macblair221/eeg-signal-acquisition/README.md

# Low-Cost Electrophysiology Acquisition System

A personal engineering project building a reproducible, low-cost bio-signal acquisition pipeline from bare analog front-end hardware to digital neural data analysis.

## Project Goal

Develop a low-cost, full-stack system for collecting and analyzing electrophysiological biosignals (ECG/EEG) using off-the-shelf components. This project bridges analog signal conditioning, microcontroller-based digital telemetry, and Python-based signal processing to successfully extract and analyze microvolt-level biological signals. 

This project is for learning, prototyping, and non-medical experimentation only.

## Current Progress & Milestones Achieved

### 1. Analog Front-End Hardware (Completed)
- Designed and simulated a full analog signal chain in LTspice using an AD620ANZ instrumentation amplifier and TL084 op-amp gain stages.
- Successfully built the physical circuit on a breadboard, implementing an RC high-pass filter for low-frequency drift reduction and an RC low-pass filter ($f_c \approx 40.8\text{ Hz}$) to attenuate 60Hz interference.
- Engineered a 2.4V DC bias to safely couple the alternating biological current into the Arduino's 0-5V digital domain.

### 2. Digital Telemetry & Data Acquisition (Completed)
- Established a real-time serial communication bridge using an Arduino Nano Every.
- Wrote a Python collection script utilizing `pyserial` to capture the 10-bit ADC byte stream at a 200Hz sampling rate and log the raw telemetry to a local CSV.

### 3. Signal Processing & Algorithm Validation (IP)
- Ingested the raw hardware array into `mne-python` 
- Applied a 1Hz to 40Hz digital bandpass filter to eliminate residual DC baseline wander and high-frequency breadboard noise.
- Engineered and debugged an automated peak-detection algorithm using `scipy.signal.find_peaks`, utilizing minimum-voltage thresholds to prevent false-positive wave detection and extract a resting heart rate.

## Results & Signal Processing

The system was validated using a Lead I ECG placement (gold-plated cup electrodes and Ten20 conductive paste).

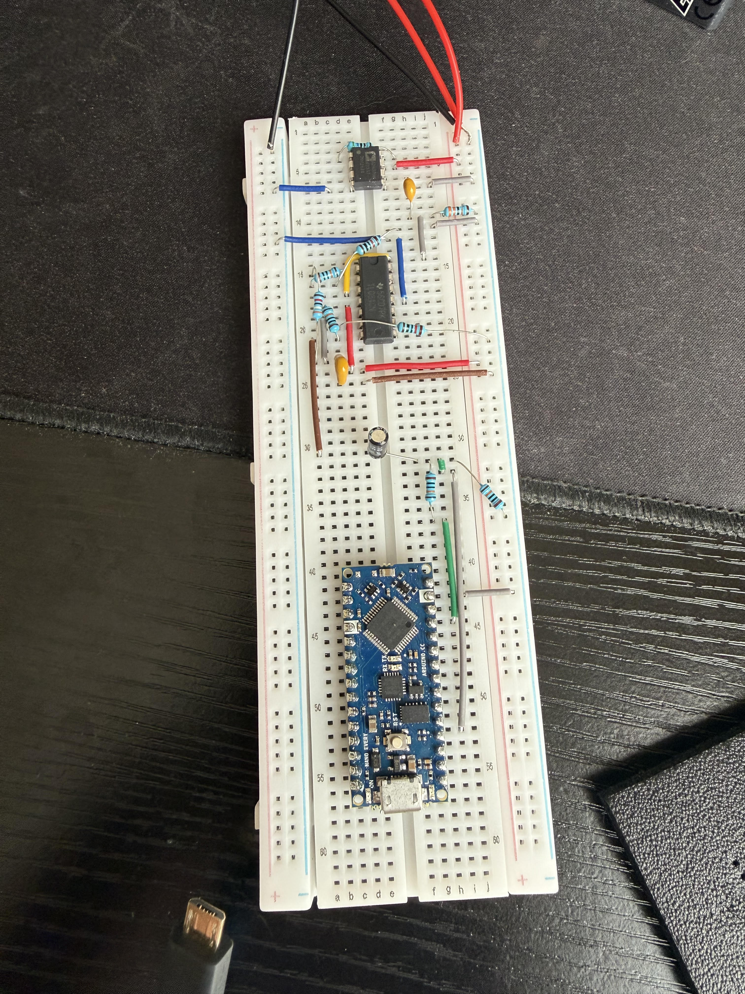
[picture p1: images/real_circuit_build.jpg]
Full Circuit


*The physical analog amplification and filtering chain bridged to the Arduino 10-bit ADC.*

## Simulation Gallery

LTspice schematic design for analog front-end using universal OpAmp.

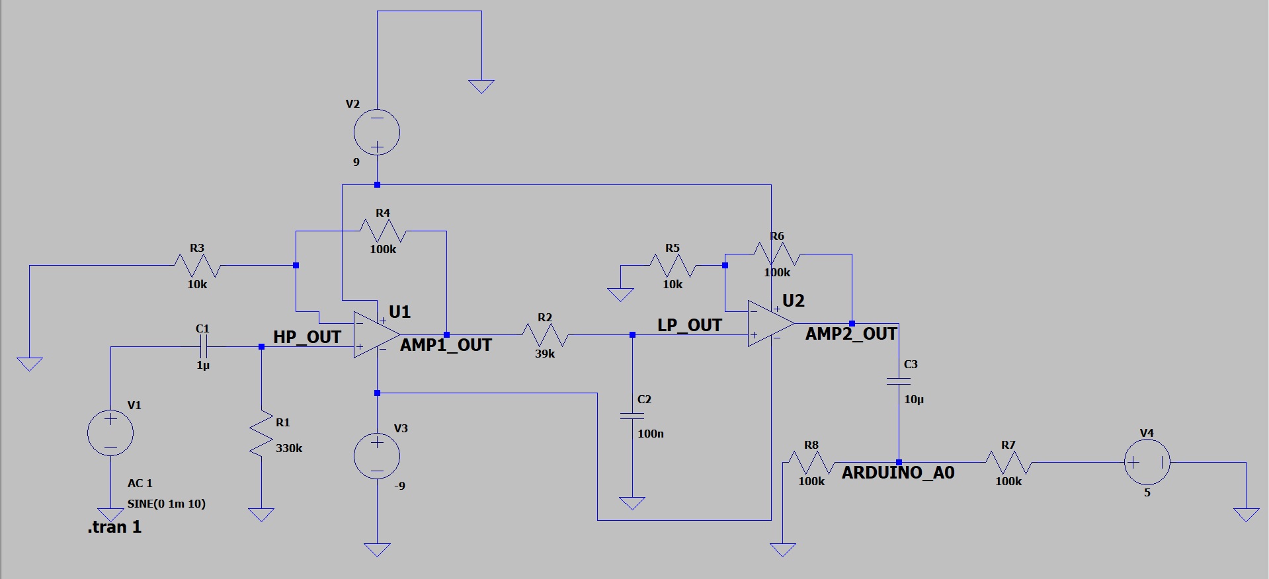
[picture p2: images/schematics_images/LTspice_OpAmp_BandPass.jpg]
LTspice Schematic of Analog Front-End


Transient simulation of an EEG-like input containing a 10 Hz signal, 60 Hz noise, and slow drift after passing through the analog front-end. 

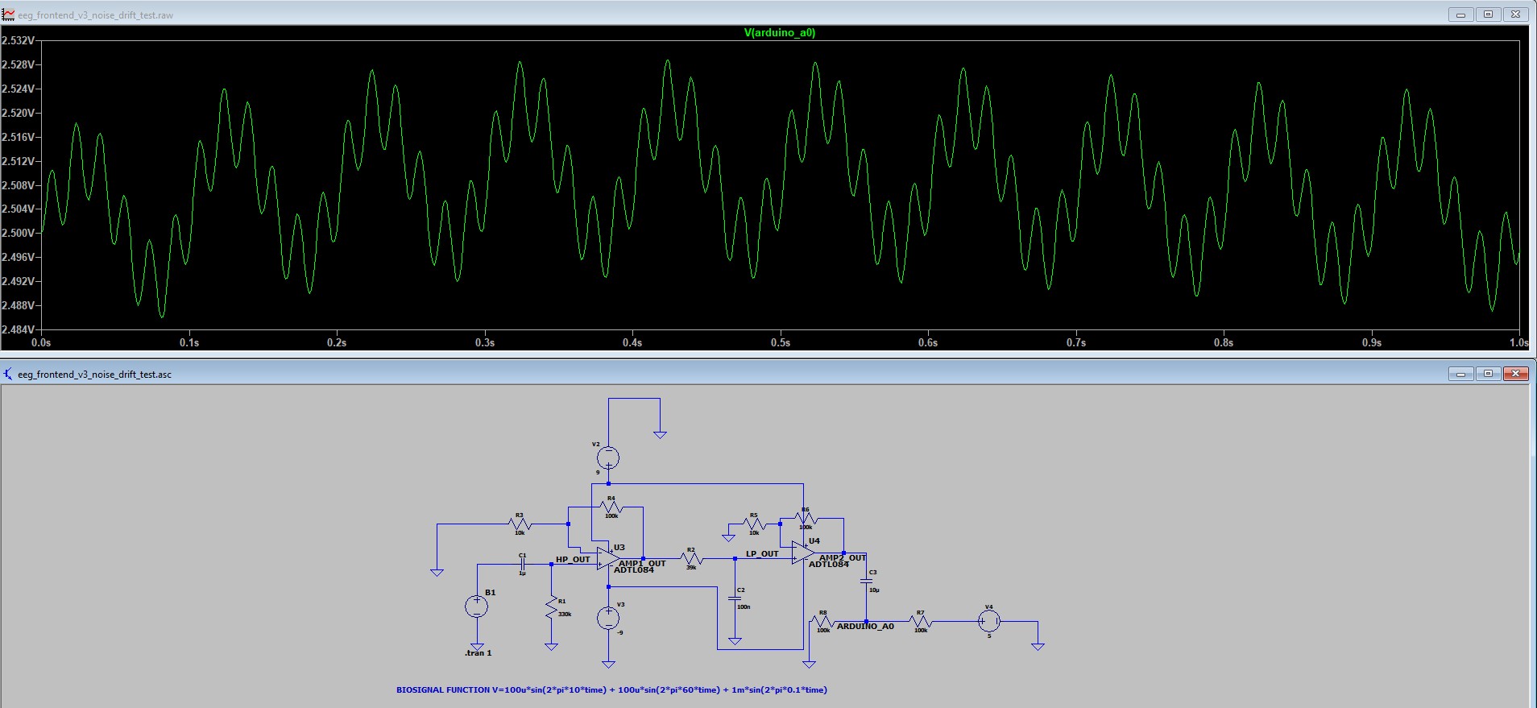
[picture p3: images/schematics_images/eeg_frontend_noise_drift_schematic_output.jpg]
LTspice transient simulation of noisy EEG-like signal at Arduino input


Full front-end design utilizing an AD620 instrumentation Amplifier

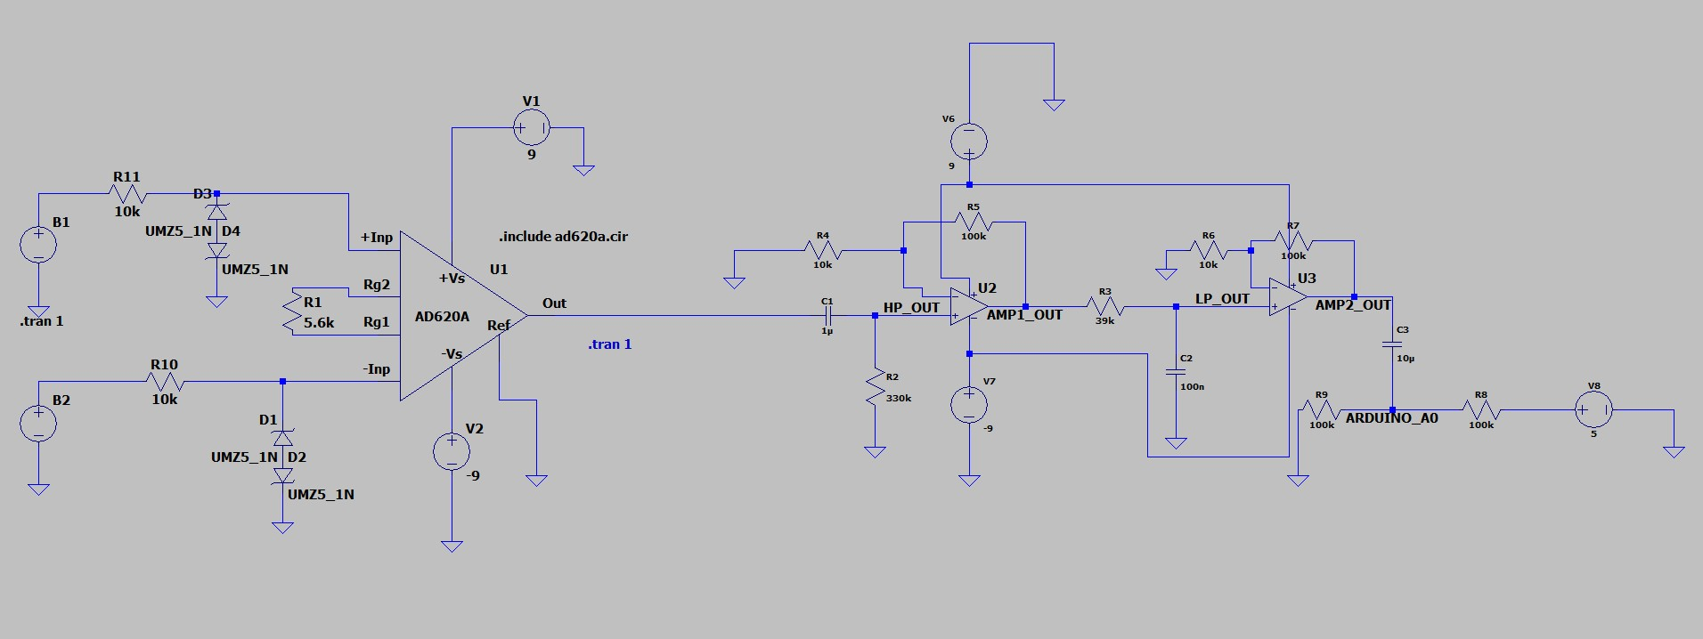
[picture p4: images/schematics_images/eeg_full_frontend_input_protection.jpg]
Full LTspice schematic (AD620)


## Repository Structure

```text
ltspice/
  eeg_frontend_v1_ac_analysis.asc
  eeg_frontend_v1_transient.asc

src/
  record_ecg.py
  signal_processing.ipynb

images/
    ...
```

## Next Steps
- Refine Arduino IDE code to better accommodate the sampling frequency. Originally hardcoded a 200Hz sampling rate but got a true $f_s \approx 190.6\text{ Hz}$ sampling rate. Hardcoding the 200Hz sampling rate meant the MNE bandpass filter assumed each sample is 1/200th of a second apart when it was really 1/190.6th of a second apart. This squeezes the samples I had into a tighter window, making my measured heartbeat faster than it really was.
- Re-tune the analog gain stages to accommodate $50\mu\text{V}$ EEG brainwaves.
- Transition electrode placement to the frontal lobe/occipital lobe for Alpha-wave detection experiments.
- Implement real-time Fast Fourier Transform (FFT) analysis to calculate Power Spectral Density (PSD). (must dial in sampling rate discrepancies first)

## Tech Stack
- Hardware: Gold-plated cup electrodes, Arduino Nano Every, AD620ANZ instrumentation amplifier, TL084CN op-amps, discrete passive components.
- Simulation/Design: Tinkercad, LTspice.
- Data Pipeline & Analysis: Python, PySerial, Pandas, NumPy, SciPy, MNE-Python, Matplotlib.
