macblair221/eeg-signal-acquisition/images/mne_filtered_ecg.png

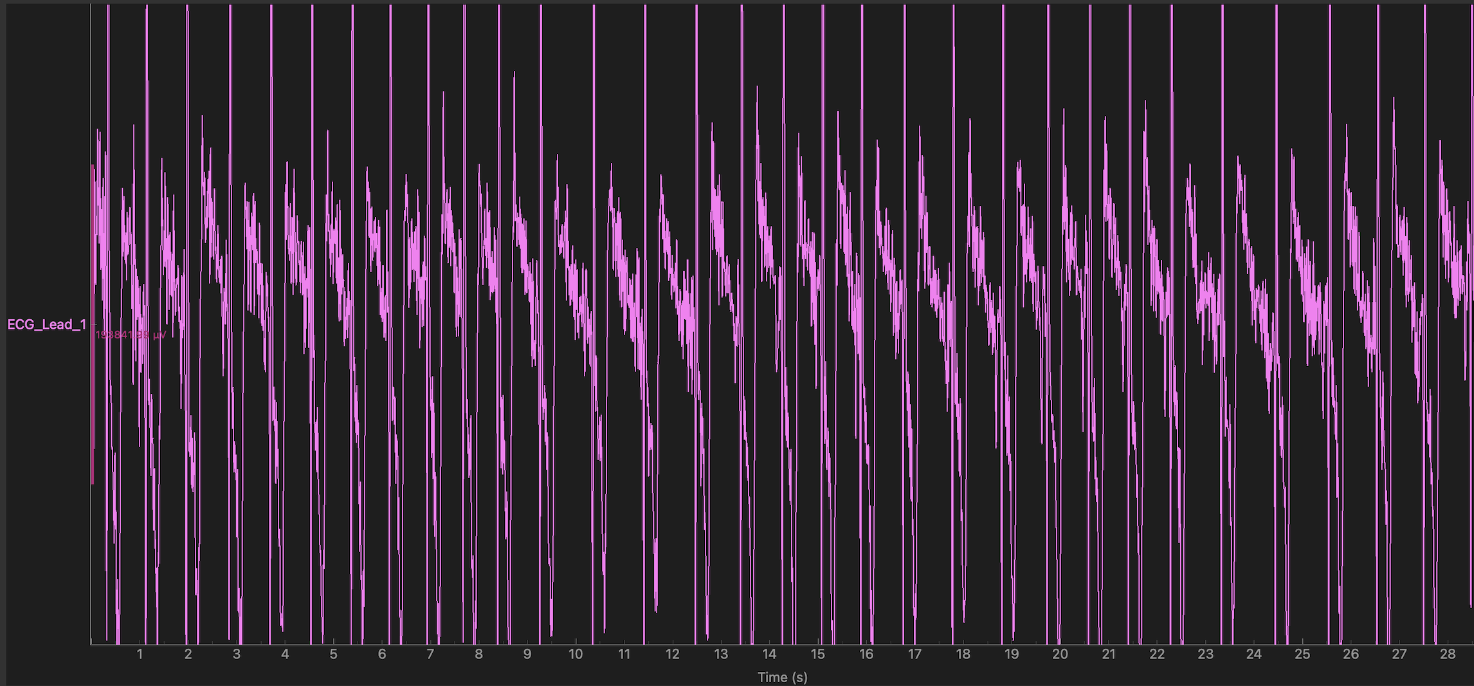
images/mne_filtered_ecg.png
