macblair221/eeg-signal-acquisition/images/schematics_images/ADTL084_10u_input_to_output.jpg

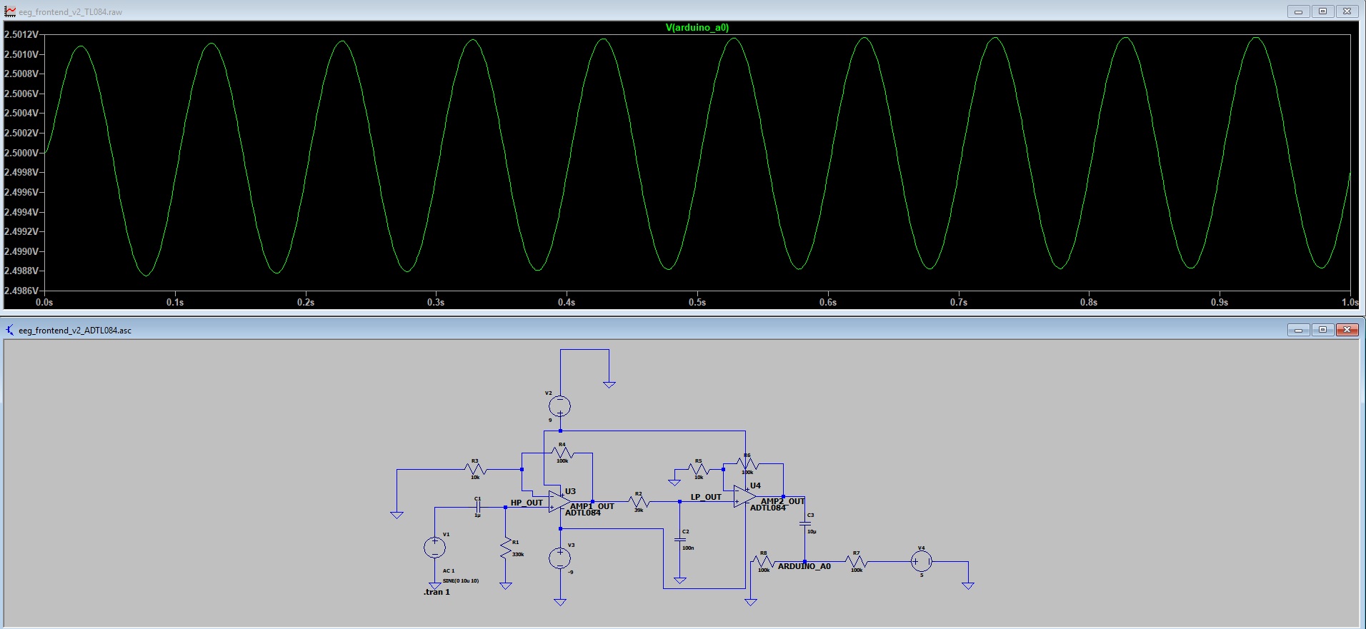
images/schematics_images/ADTL084_10u_input_to_output.jpg
