macblair221/eeg-signal-acquisition/images/schematics_images/Analog_FrontEnd_TinkerCAD_Schematic.jpg

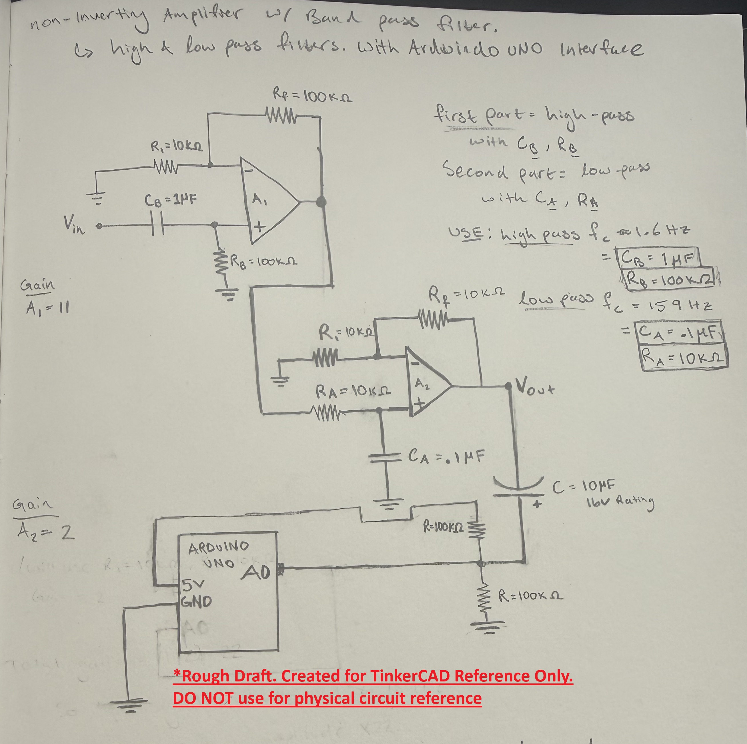
images/schematics_images/Analog_FrontEnd_TinkerCAD_Schematic.jpg
