macblair221/eeg-signal-acquisition/images/schematics_images/eeg_frontend_AD620A_ADTL084.jpg

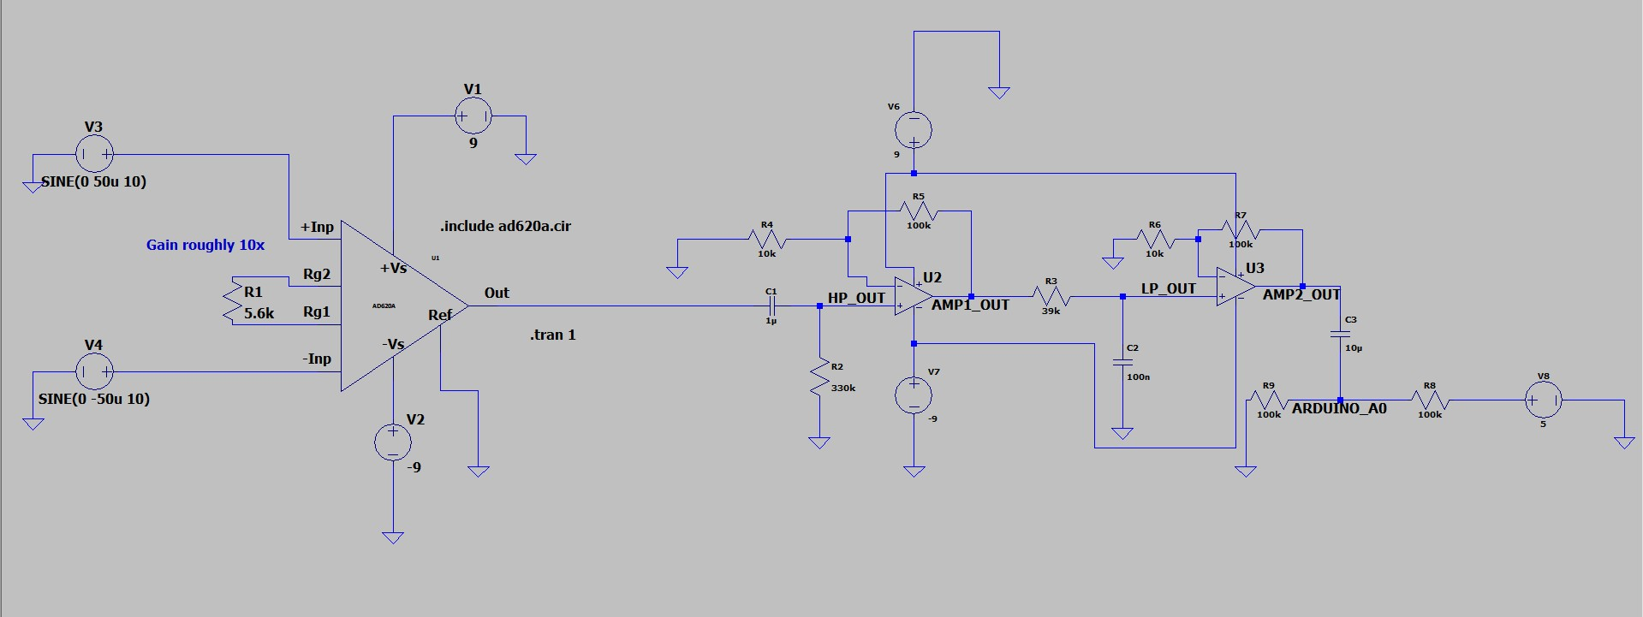
images/schematics_images/eeg_frontend_AD620A_ADTL084.jpg
