macblair221/eeg-signal-acquisition/images/schematics_images/eeg_frontend_AD620A_differntial_noise.jpg

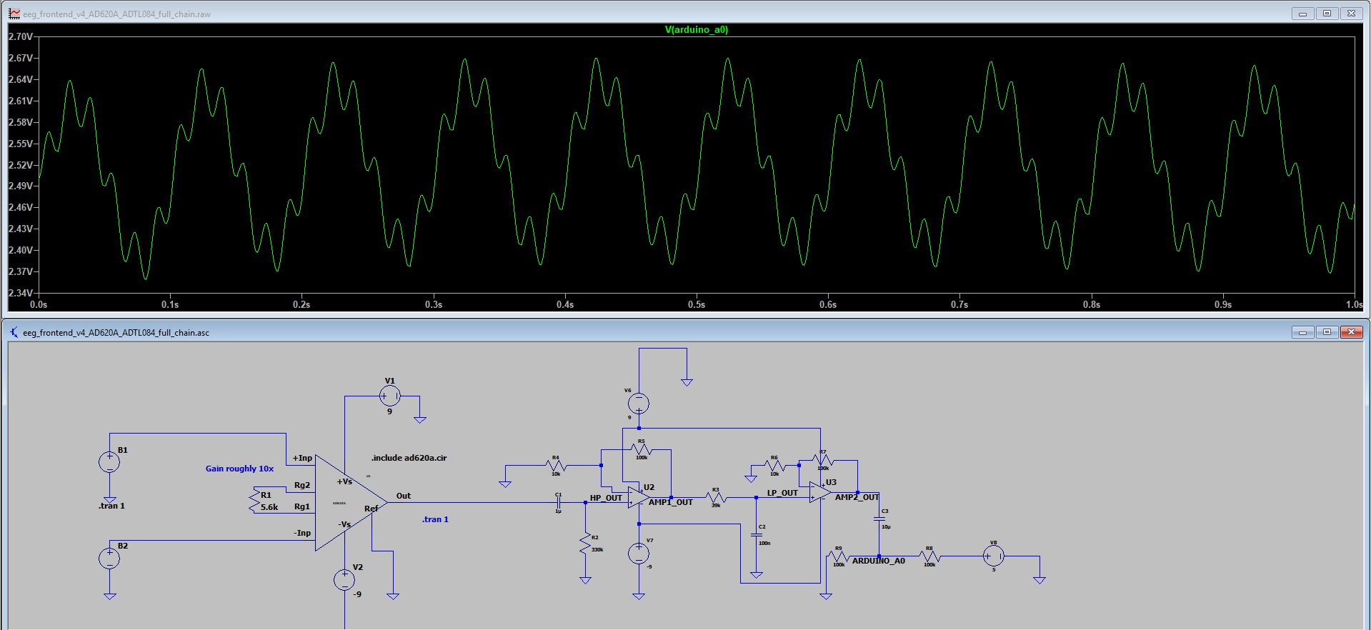
images/schematics_images/eeg_frontend_AD620A_differntial_noise.jpg
