macblair221/eeg-signal-acquisition/images/schematics_images/eeg_frontend_AD620A_final_output.jpg

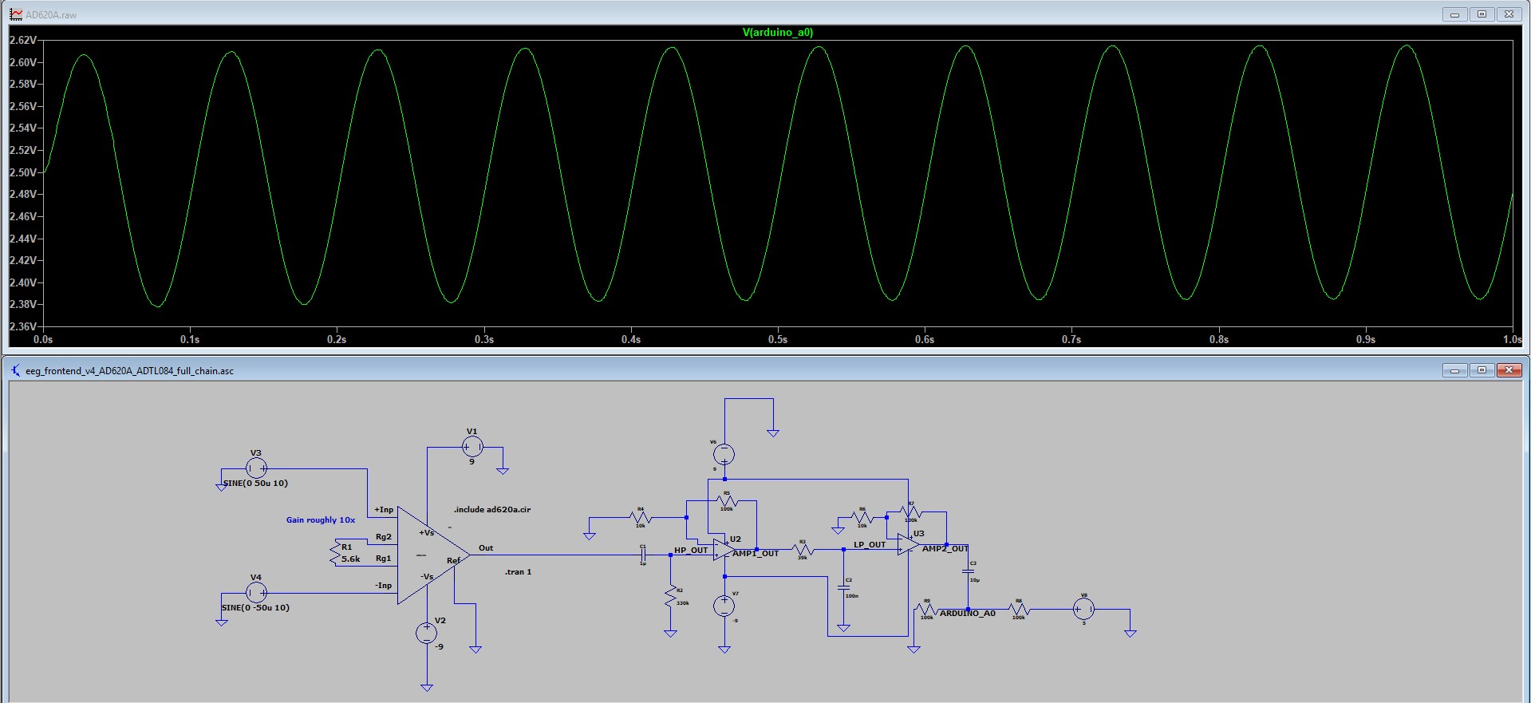
images/schematics_images/eeg_frontend_AD620A_final_output.jpg
