macblair221/eeg-signal-acquisition/images/schematics_images/eeg_frontend_noise_drift_1sec.jpg

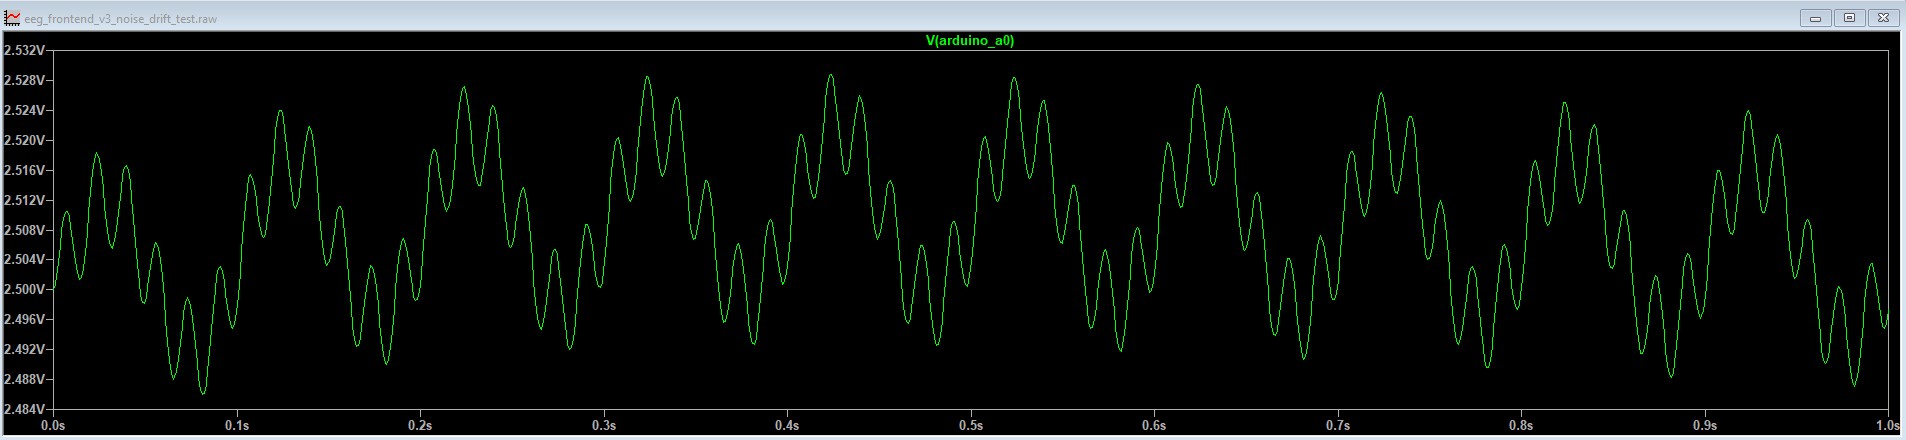
images/schematics_images/eeg_frontend_noise_drift_1sec.jpg
