macblair221/eeg-signal-acquisition/ltspice/eeg_frontend_v4_AD620A_ADTL084_full_chain.asc

C1: cap; 1µ
C2: cap; 100n
C3: cap; 10µ
R1: res; 5.6k
R2: res; 330k
R3: res; 39k
R4: res; 10k
R5: res; 100k
R6: res; 10k
R7: res; 100k
R8: res; 100k
R9: res; 100k
U1: AD620A
U2: UniversalOpAmp2
U3: UniversalOpAmp2
V1: voltage; 9
V2: voltage; -9
V3: voltage; SINE(0 50u 10)
V4: voltage; SINE(0 -50u 10)
V6: voltage; 9
V7: voltage; -9
V8: voltage; 5
Named nets: 0, ARDUINO_A0, AMP2_OUT, LP_OUT, AMP1_OUT, HP_OUT
.include ad620a.cir
Gain roughly 10x
.tran 1
