macblair221/eeg-signal-acquisition/ltspice/eeg_frontend_v1_ac_analysis.asc

C1: cap; 1µ
C2: cap; 100n
C3: cap; 10µ
R1: res; 330k
R2: res; 39k
R3: res; 10k
R4: res; 100k
R5: res; 10k
R6: res; 100k
R7: res; 100k
R8: res; 100k
U1: UniversalOpAmp2
U2: UniversalOpAmp2
V1: voltage; SINE(0 1m 10); AC 1
V2: voltage; 9
V3: voltage; -9
V4: voltage; 5
Named nets: 0, ARDUINO_A0, AMP2_OUT, LP_OUT, AMP1_OUT, HP_OUT
.tran 1
.ac dec 200 .01 1000
