macblair221/eeg-signal-acquisition/(commit log)

2026-05-16 Enhance gallery section with schematic descriptions
    Added descriptions for hand-drawn and LTspice schematics.
2026-05-16 Add files via upload
    Add image for analog front-end design using ADTL084 OpAmps with 10 microvolt input. Output shows node at Arduino biased to +2.5V.
2026-05-16 Update gallery with additional schematic images
    Added images of schematics for analog front-end designs.
