macblair221/eeg-signal-acquisition/images/parts/AD620ANZ.jpeg

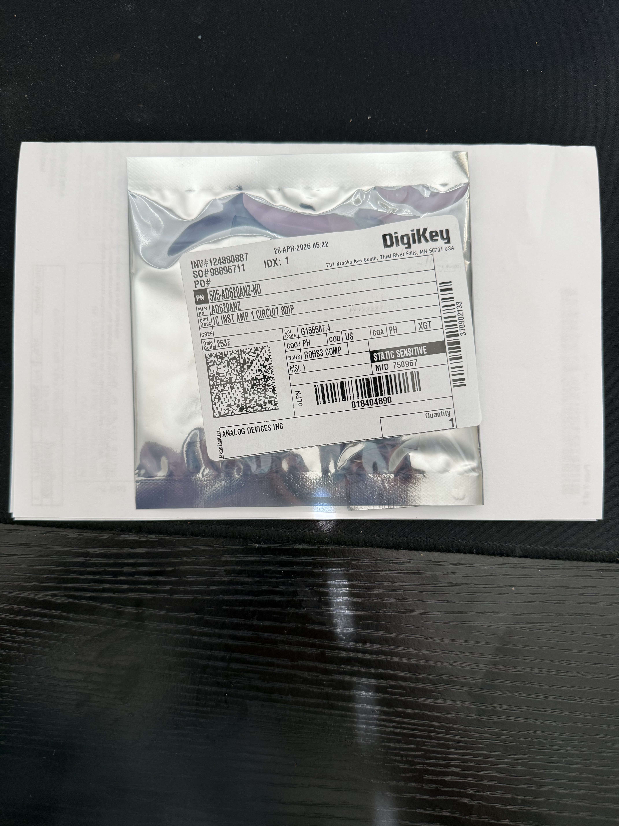
images/parts/AD620ANZ.jpeg
