macblair221/eeg-signal-acquisition/images/parts/opAmps.jpeg

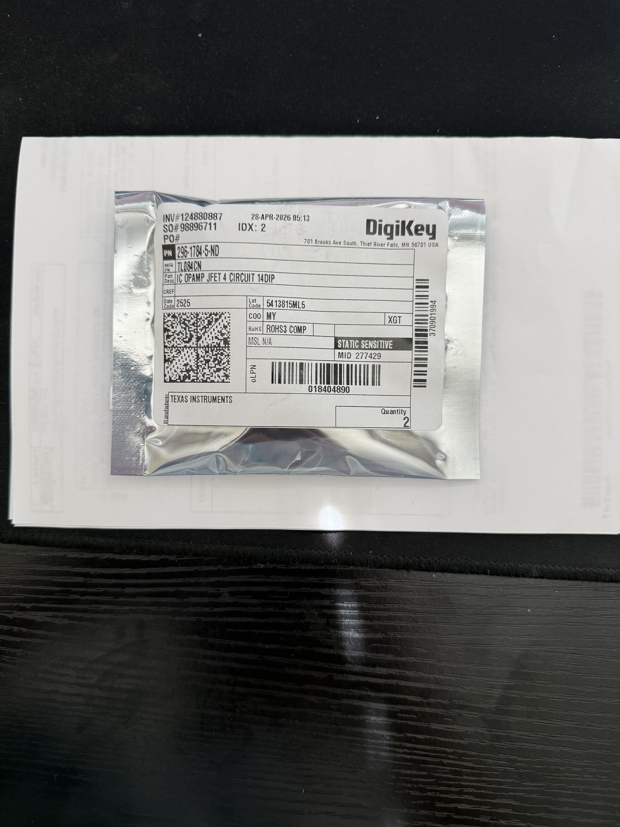
images/parts/opAmps.jpeg
